microfarad-de/antenna-tuner/doc/antenna-tuner-schematic.png

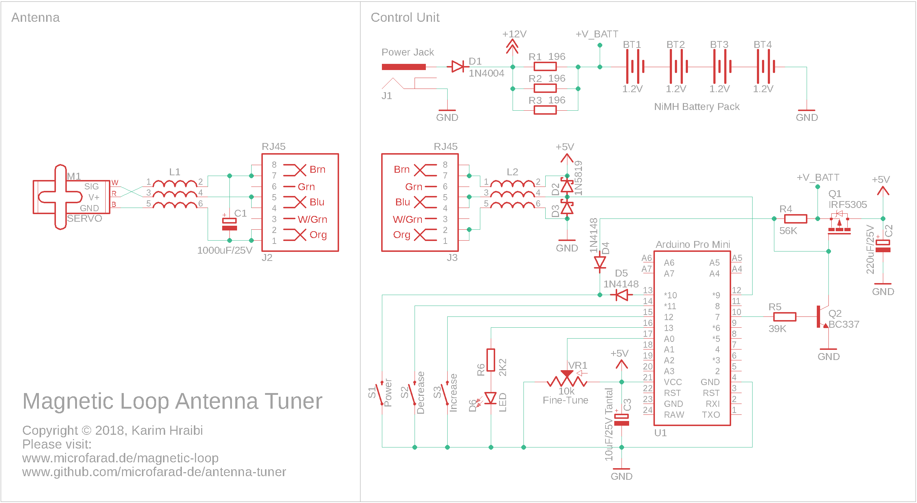
doc/antenna-tuner-schematic.png
