microfarad-de/antenna-tuner/(commit log)

2018-12-23 Added antenna tuner schematic
2018-12-24 Updated circuit diagram
2019-01-02 Revert line endings to LF
    [antenna-tuner.ino]
2019-02-02 Update bill of material
    [antenna-tuner-bill-of-material.csv]
2019-06-20 Update and rename adc.cpp to Adc.cpp
2019-06-20 Update and rename adc.h to Adc.h
2020-03-12 Switch to submodules
2020-03-12 Switched the Button submodule to master branch
